superwofy/E9X-M-CAN-Integration-Module/CAN messages/F-series BN2010/0x5E3 iDrive settings to other modules.txt

Independent ventilation Timer2:
11 03 00 02 03 17 FD FF                             // Active: 3:23, Identical to BN2000 0x5E2
