superwofy/E9X-M-CAN-Integration-Module/CAN messages/F-series BN2010/0x291 Sport displays unit settings.txt

Byte4 first half - Torque
Byte4 second half - Power

Torque:

Nm:
00 03 00 00 10 F0

Ft lb:
00 03 00 00 20 F0

kgm:
00 03 00 00 30 F0

Power:

KW:
00 03 00 00 01 F0

hp:
00 03 00 00 02 F0
