superwofy/E9X-M-CAN-Integration-Module/CAN messages/E-series BN2000/0x130 terminal status.png

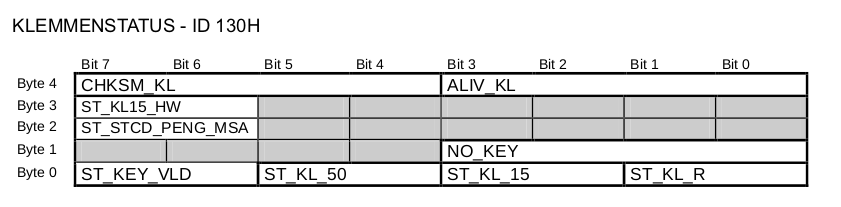
CAN messages/E-series BN2000/0x130 terminal status.png
