superwofy/E9X-M-CAN-Integration-Module/CAN messages/F-series BN2010/0x1A1 Speed.png

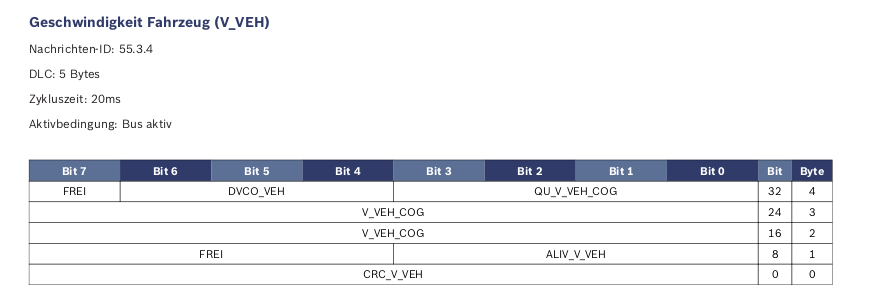
CAN messages/F-series BN2010/0x1A1 Speed.png
