superwofy/E9X-M-CAN-Integration-Module/Firmware changes/SVT70 Servotronic/BDM pinout.jpg

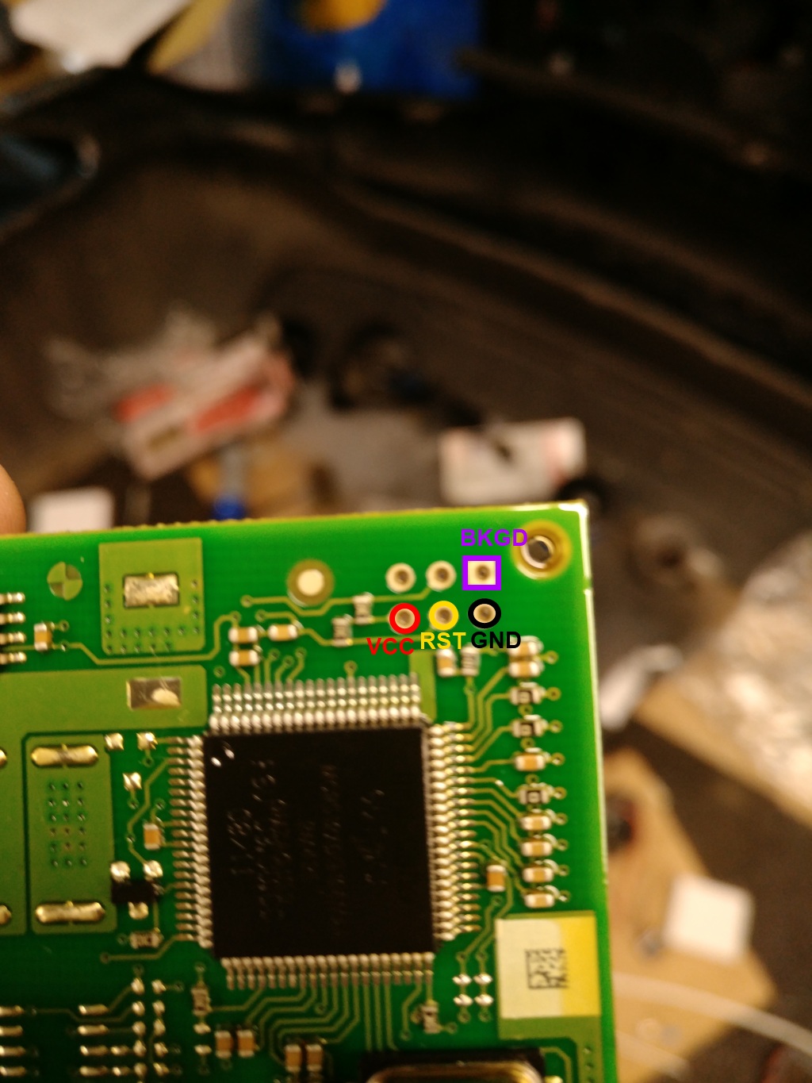
Firmware changes/SVT70 Servotronic/BDM pinout.jpg
