superwofy/E9X-M-CAN-Integration-Module/Images/board/board-back.jpg

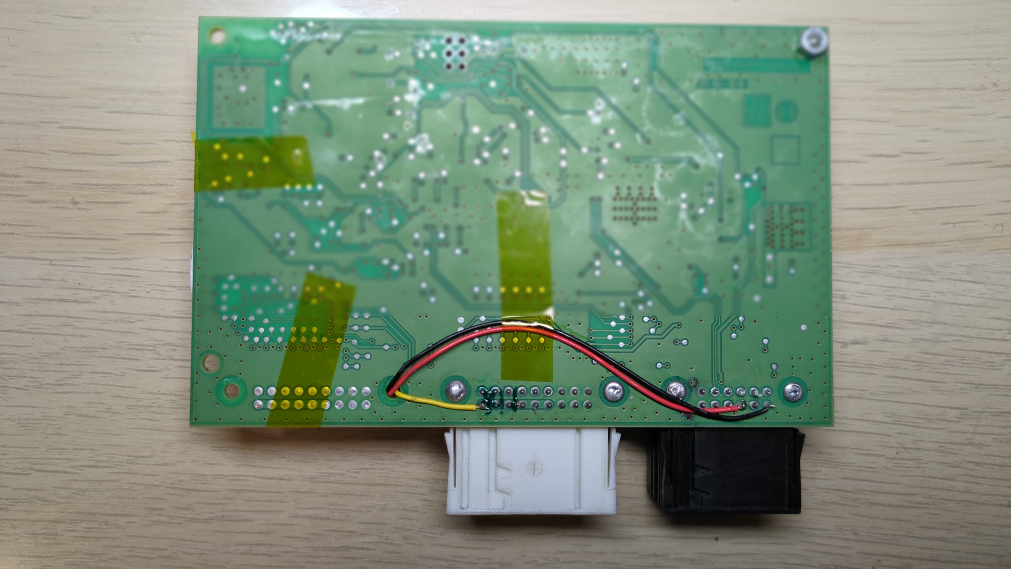
Images/board/board-back.jpg
