superwofy/E9X-M-CAN-Integration-Module/Images/CIC/idrive-settings.jpg

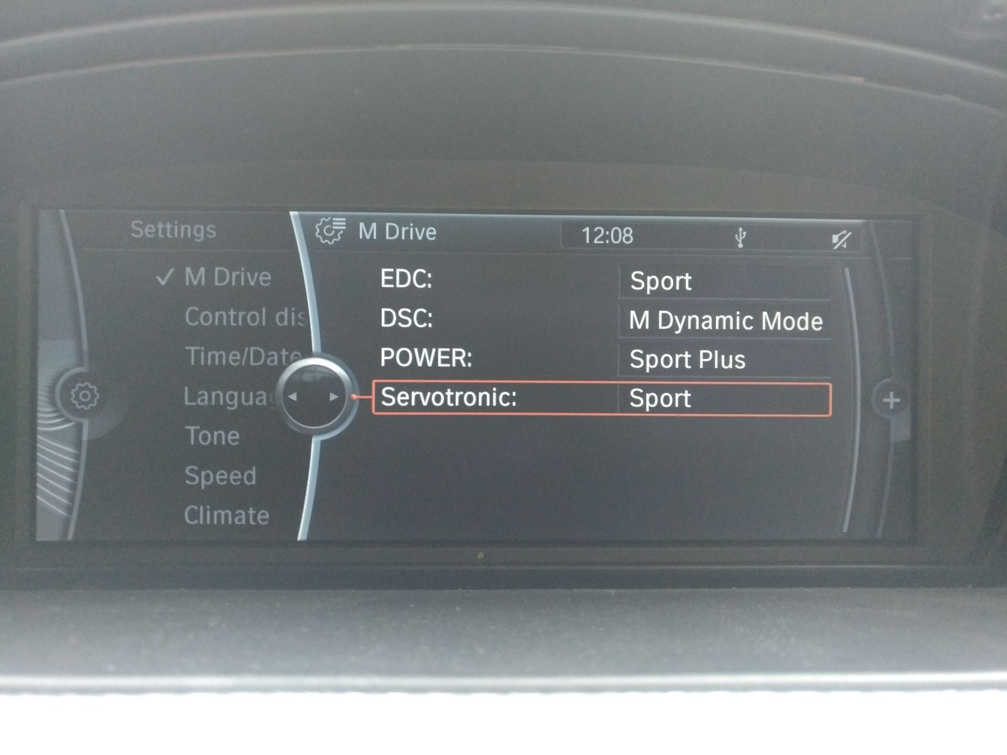
Images/CIC/idrive-settings.jpg
