superwofy/E9X-M-CAN-Integration-Module/Images/CIC/m-key-settings.jpg

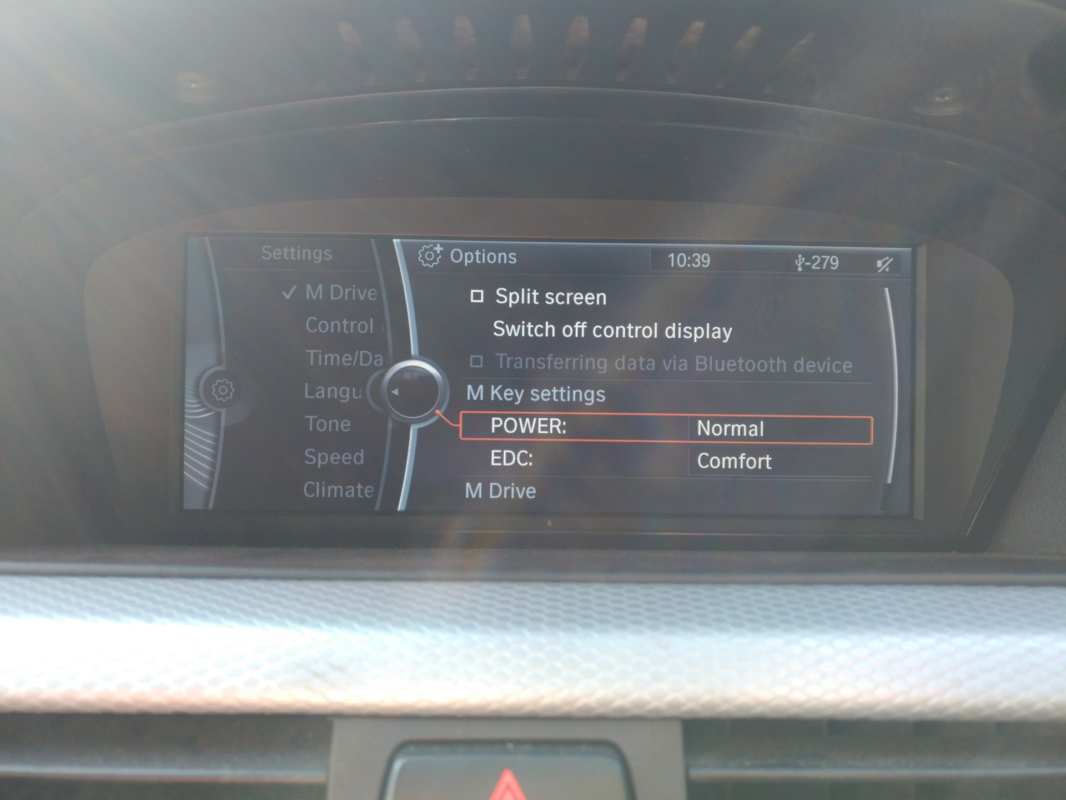
Images/CIC/m-key-settings.jpg
