superwofy/E9X-M-CAN-Integration-Module/Images/cpu-clock-temperature-lifetime.png

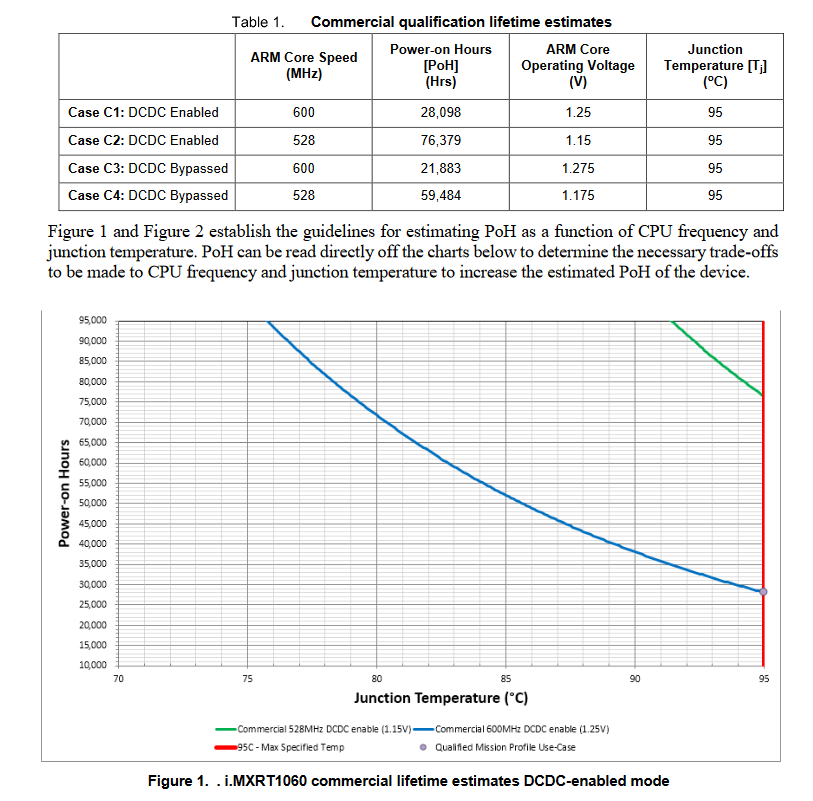
Images/cpu-clock-temperature-lifetime.png
