superwofy/E9X-M-CAN-Integration-Module/Images/exhaust-flap-flyback.jpg

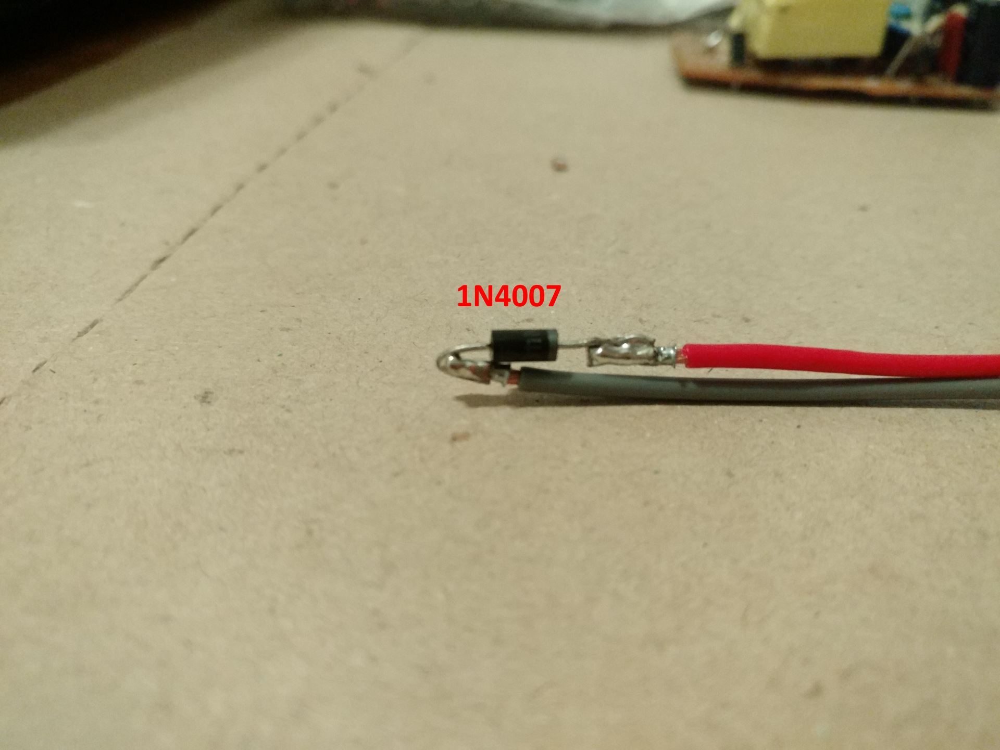
Images/exhaust-flap-flyback.jpg
