superwofy/E9X-M-CAN-Integration-Module/Images/Fog/indicator off.jpg

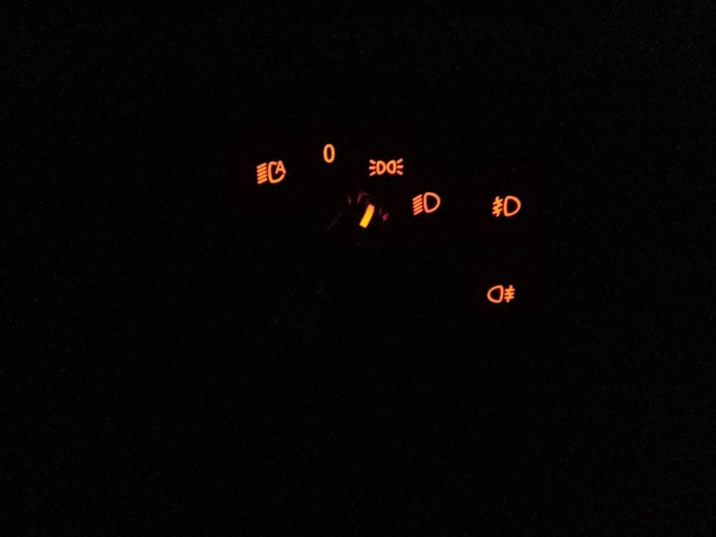
Images/Fog/indicator off.jpg
