superwofy/E9X-M-CAN-Integration-Module/Images/Fog/light switch.jpg

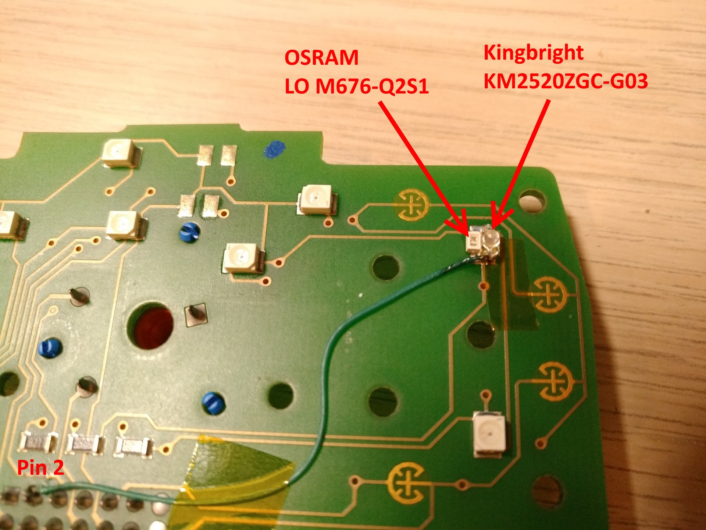
Images/Fog/light switch.jpg
