superwofy/E9X-M-CAN-Integration-Module/Images/launch-control/cid.jpg

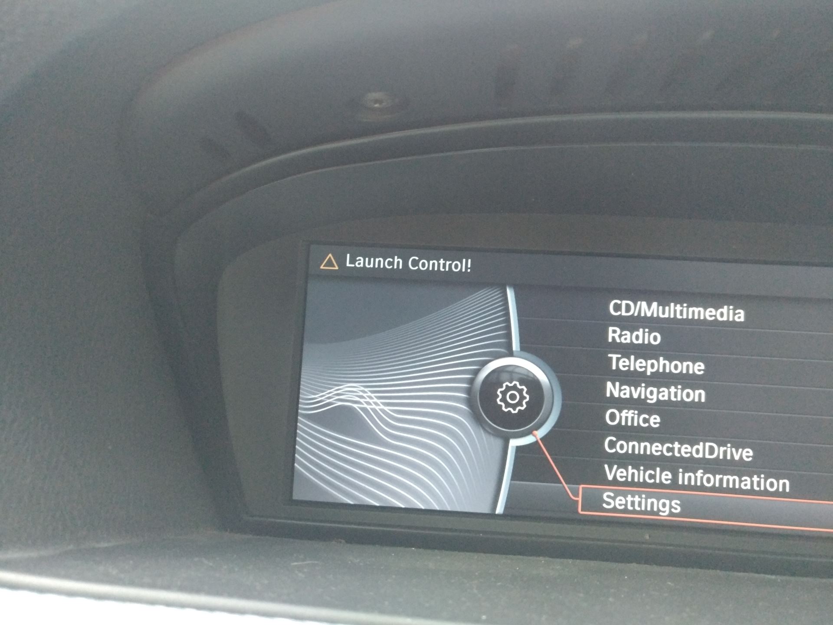
Images/launch-control/cid.jpg
