superwofy/E9X-M-CAN-Integration-Module/Images/NBT/faceplate - pinout.jpg

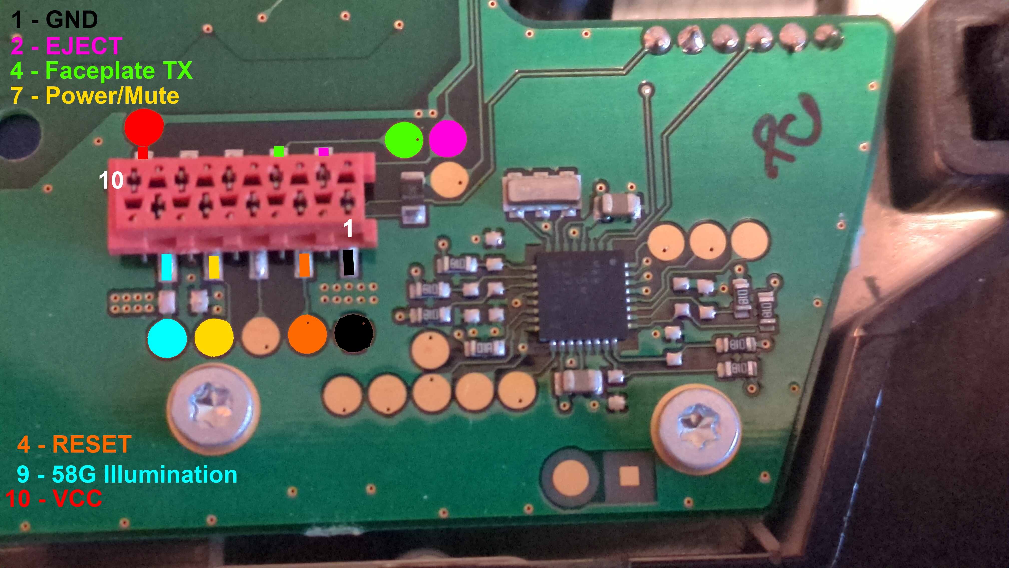
Images/NBT/faceplate - pinout.jpg
