superwofy/E9X-M-CAN-Integration-Module/Images/NBT/fds.jpg

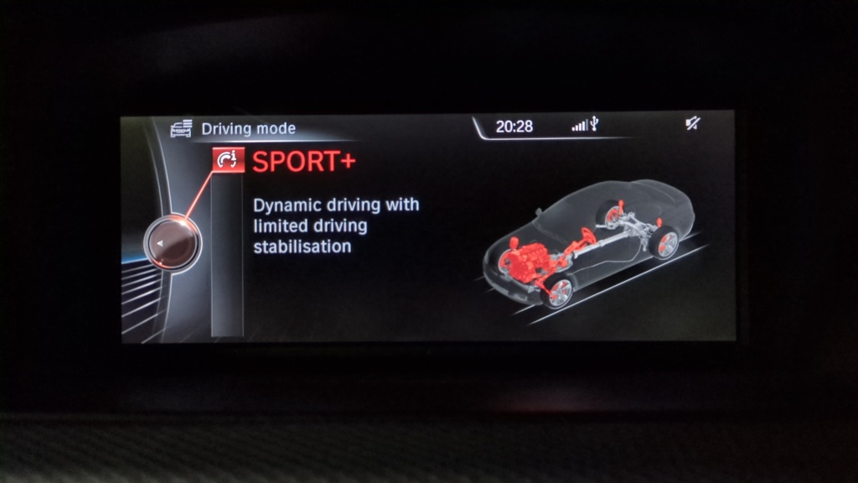
Images/NBT/fds.jpg
