superwofy/E9X-M-CAN-Integration-Module/Images/NBT/mdrive.jpg

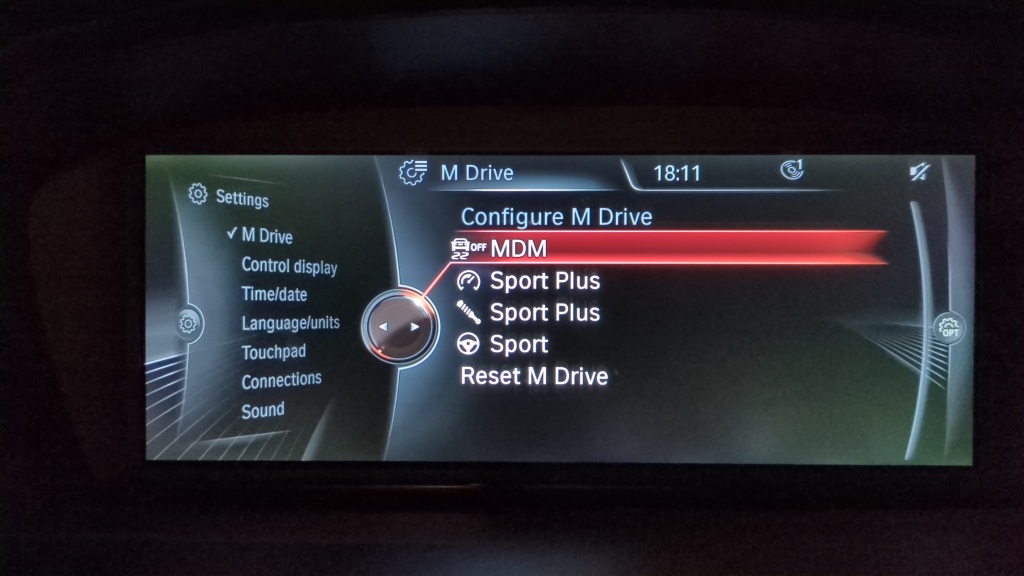
Images/NBT/mdrive.jpg
