superwofy/E9X-M-CAN-Integration-Module/Images/NBT/oil-level.jpg

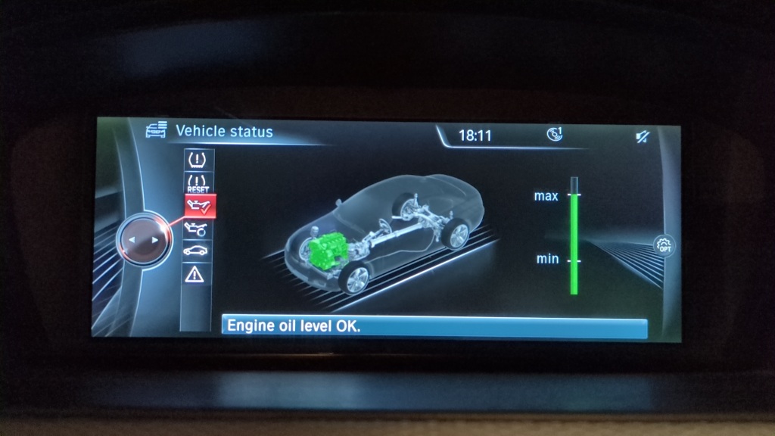
Images/NBT/oil-level.jpg
