superwofy/E9X-M-CAN-Integration-Module/Images/NBT/rpa.jpg

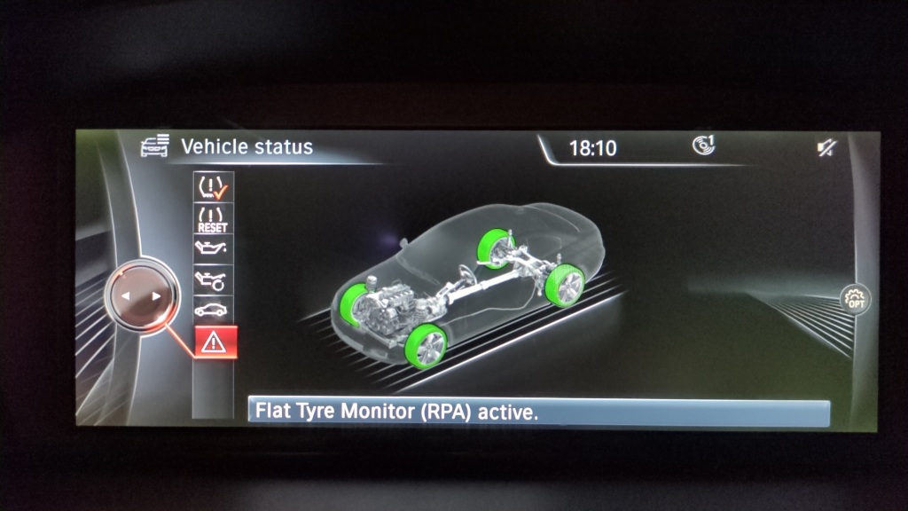
Images/NBT/rpa.jpg
