superwofy/E9X-M-CAN-Integration-Module/Images/NBT/service.jpg

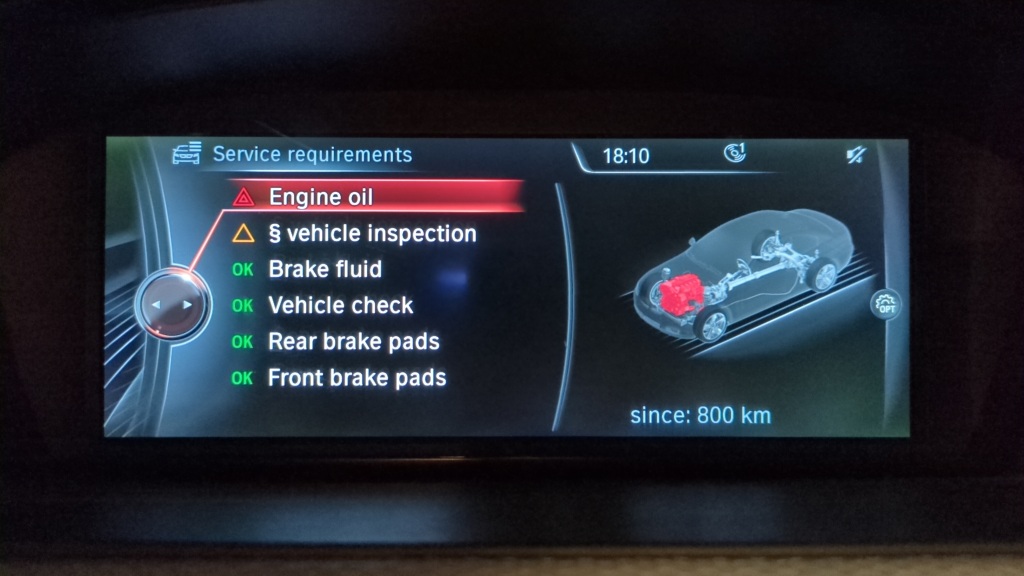
Images/NBT/service.jpg
