superwofy/E9X-M-CAN-Integration-Module/Images/NBT/sport-displays.jpg

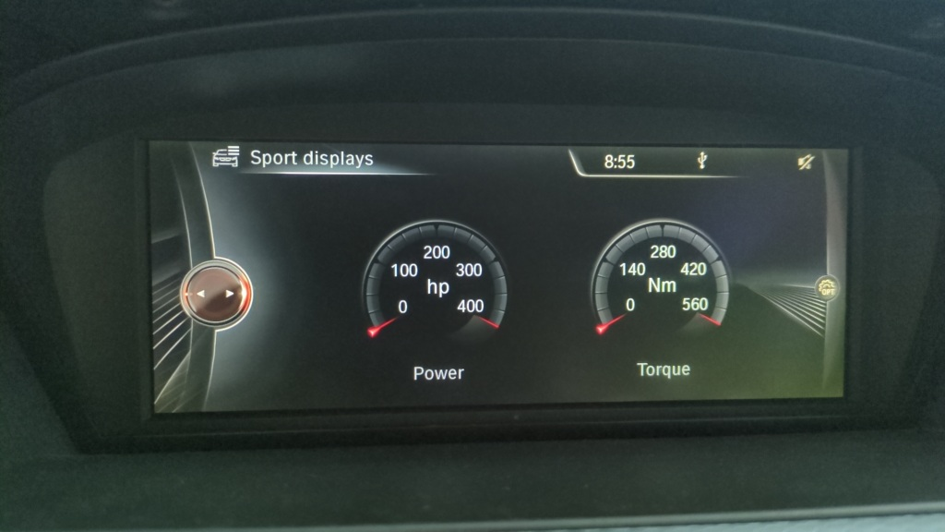
Images/NBT/sport-displays.jpg
