superwofy/E9X-M-CAN-Integration-Module/Images/POWER LED pcb.jpg

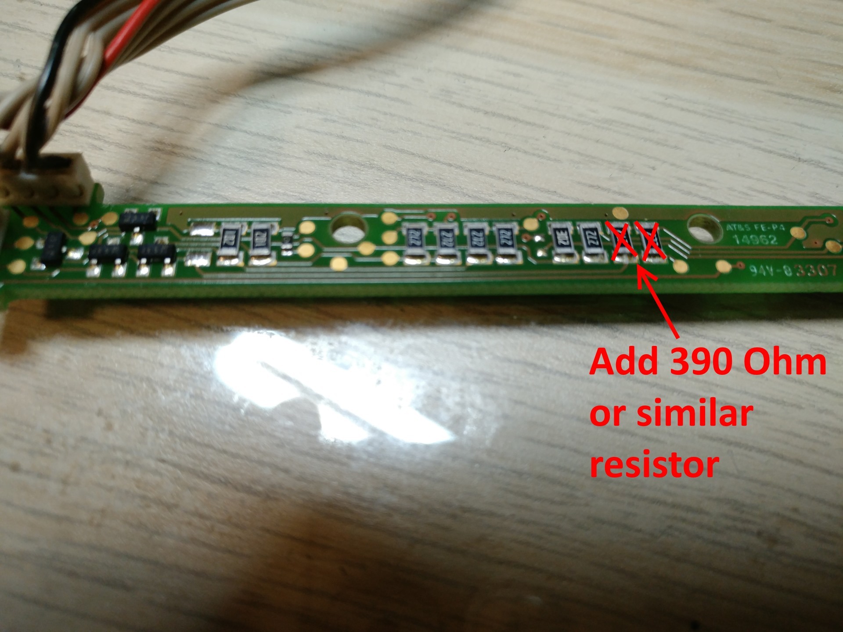
Images/POWER LED pcb.jpg
