superwofy/E9X-M-CAN-Integration-Module/Images/PTC heater/pwm circuit.jpg

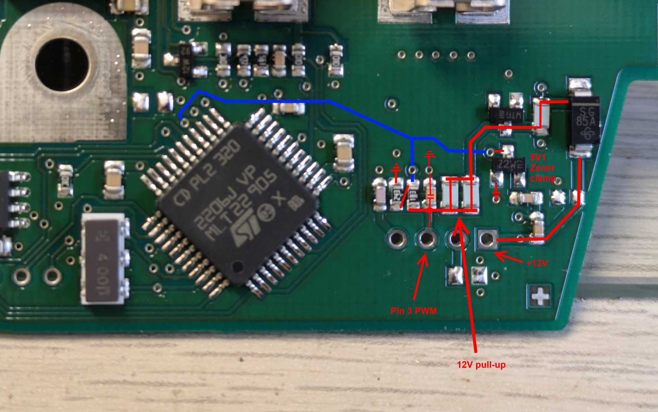
Images/PTC heater/pwm circuit.jpg
