superwofy/E9X-M-CAN-Integration-Module/img/board-all.jpg

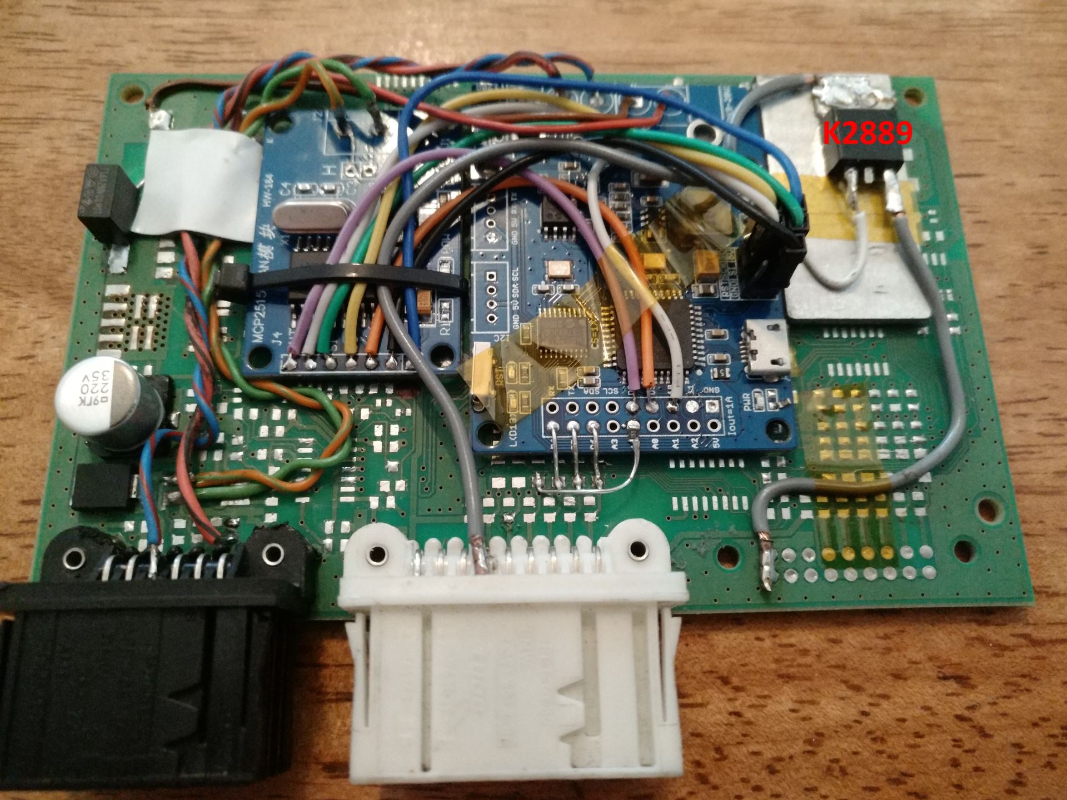
img/board-all.jpg
