superwofy/E9X-M-CAN-Integration-Module/Variable redline/kombi redline.jpg

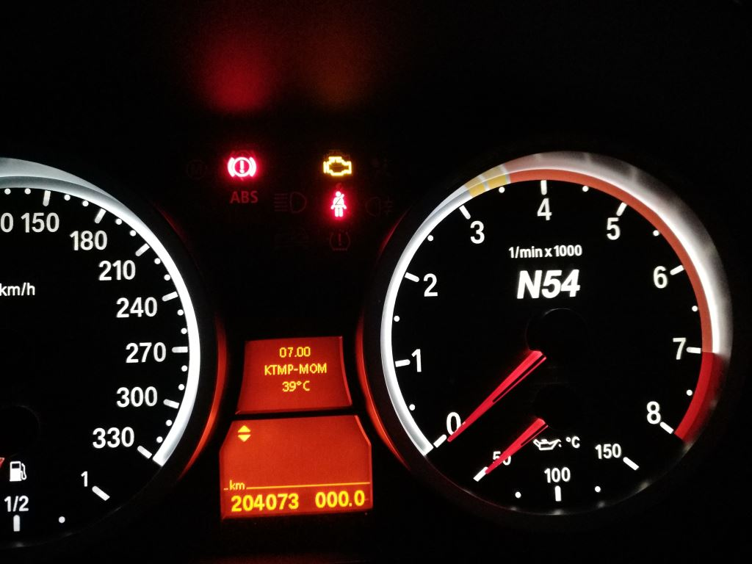
Variable redline/kombi redline.jpg
