superwofy/E9X-M-CAN-Integration-Module/Variable redline/redline graph.png

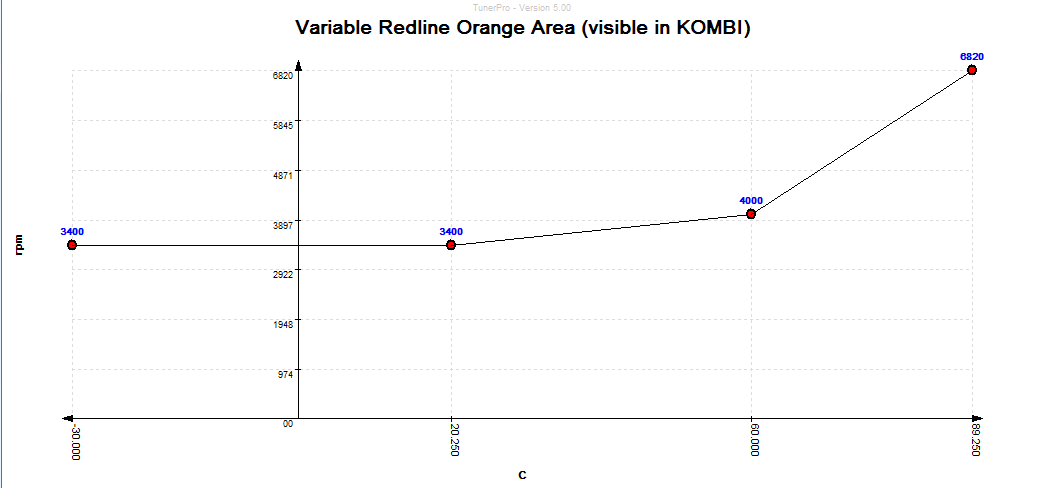
Variable redline/redline graph.png
