superwofy/E9X-M-CAN-Integration-Module/Variable redline/redline settings.png

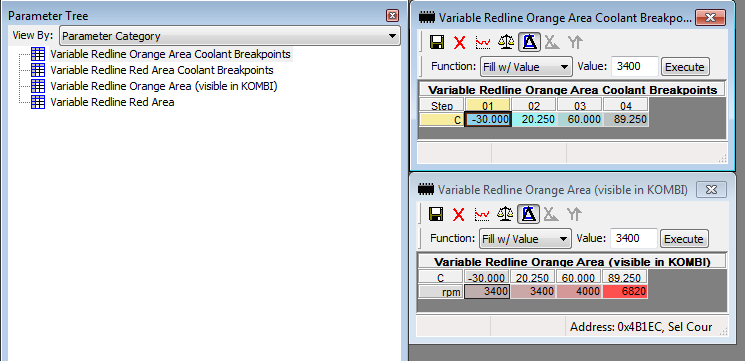
Variable redline/redline settings.png
