superwofy/E9X-M-CAN-Integration-Module/Images/NBT/ribbon soldered.jpg

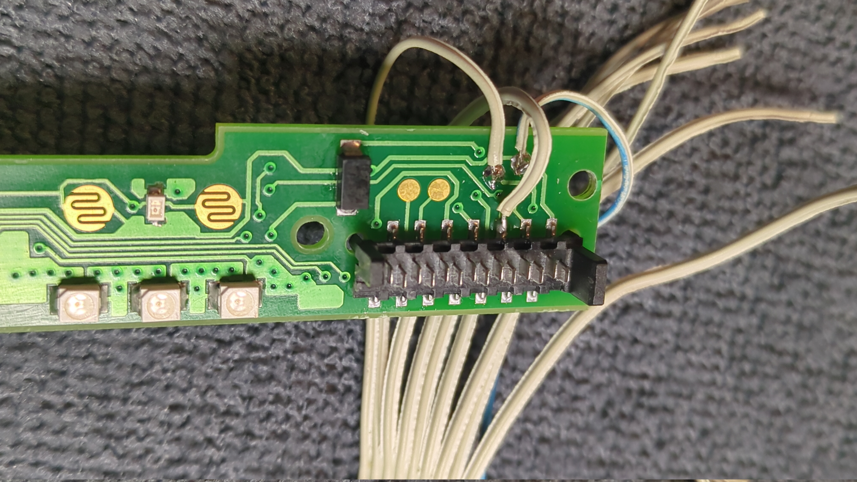
Images/NBT/ribbon soldered.jpg
