superwofy/E9X-M-CAN-Integration-Module/Firmware changes/DME MSD81/msd80 sport mode check.png

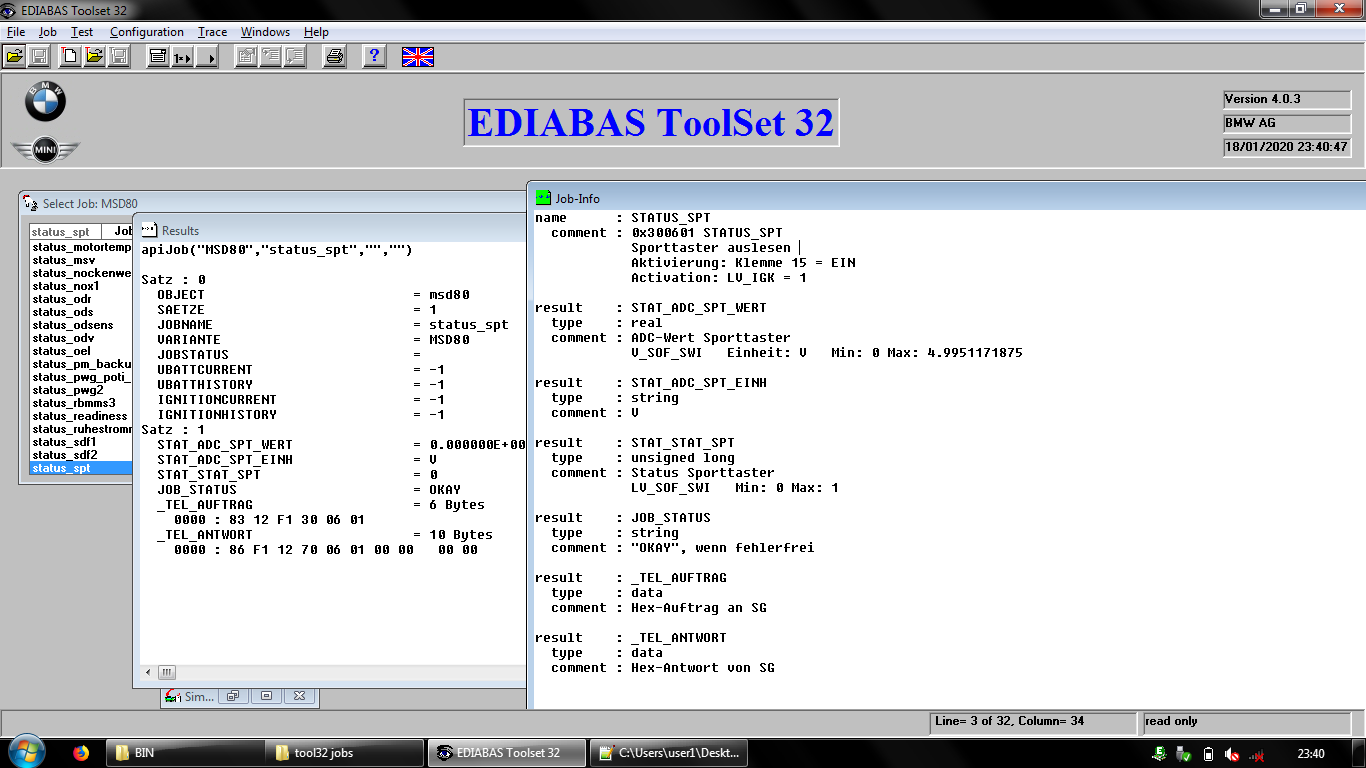
Firmware changes/DME MSD81/msd80 sport mode check.png
