superwofy/E9X-M-CAN-Integration-Module/Firmware changes/DME MSD81/Original CAN filters IKM0S.png

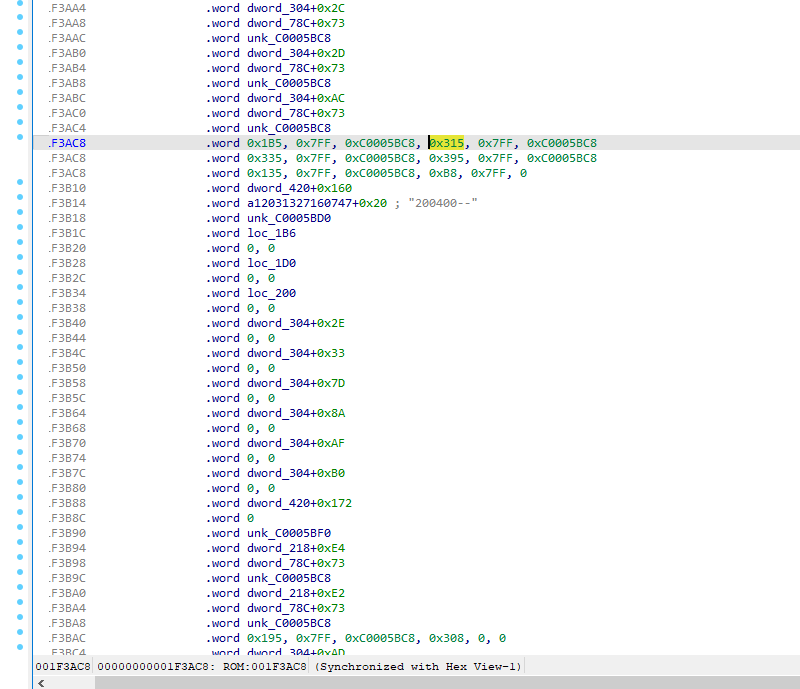
Firmware changes/DME MSD81/Original CAN filters IKM0S.png
