superwofy/E9X-M-CAN-Integration-Module/Firmware changes/DME MSD81/Original CAN table IKM0S.png

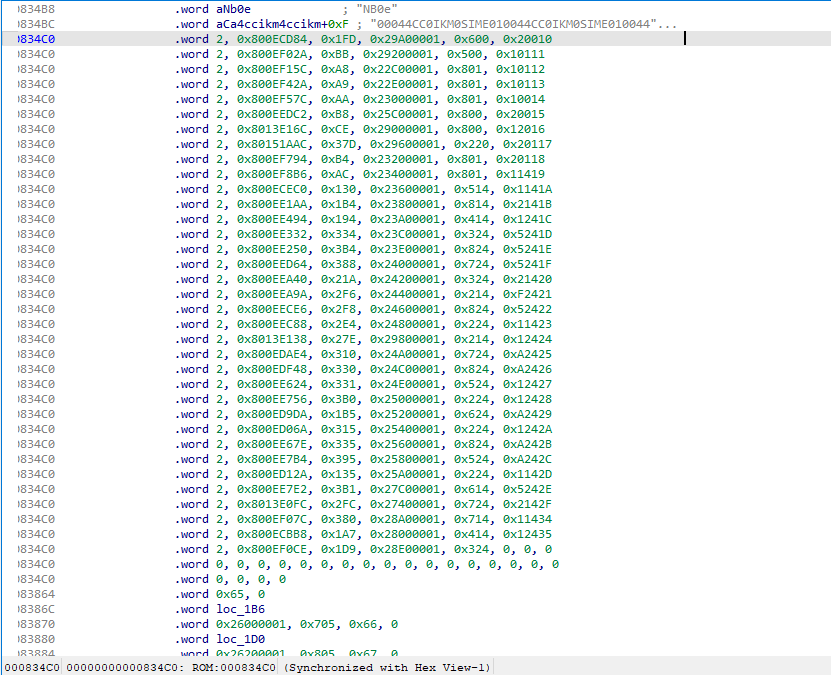
Firmware changes/DME MSD81/Original CAN table IKM0S.png
