superwofy/E9X-M-CAN-Integration-Module/(threads)

Thread 1 (2023-07-14):

Not an issue. Just something I found in the web regarding exhaust valve controlling.

Xantorhd, 2023-07-14:
Hey superwofy,

as stated in the title I found something special. I don't know whether you are interested but it's worth sharing imo.

It seems like the Exhaust valve is controlled via (I guess) PT-CAN. Message ID would be "0x6F1". Found it here:

https://f80.bimmerpost.com/forums/showthread.php?t=1366350

It's a good read. It only forces it open though. Must be a way to force it shut as well. I know it's for an F series M car but maybe BMW built that upon the existing logic on E series cars.

Hope this helps as it would be an oem+ route rather than depinning and installing a diode to control.

Cheers!

superwofy, 2023-07-14:
Apologies, I forgot to reply to this.

I did see and consider this prior but did not implement it because of a note in the IKM0S DME function manual.
It would indeed make the hardware simpler, I'd love to get rid of the transistor.

```
The flag LV_AD_DIS_EXT_ADJ is set when an external adustment is done. The flag is set back to zero
at ECU reset.
```

What I believe this implies is that for the particular drive cycle where you call this, the DME will no longer create adaptations. That's not a concession I'm willing to make.

Closed 2023-07-14.

Thread 4 (2024-06-11):

Yawrate/ NBT Entrynav

pchq4205, 2024-06-11:
Hello,
i saw you Projekt and ported some of it to one of my "Special-Retrofits" in my Car.
But i still dont understand one thing. How the Gyro emulation works.
Do you have an easier understandable example how to implement random Values to get GPS to working.
Because since the NBT Entrynav dont have an Build in Gyro i have to emulate something.
(And i am using an Arduino Mega with the standart Can Bus shield)
Thank you :)
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

superwofy, 2024-06-15:
Hello,

The yaw rate is processed by the radio on CANID 0x2F3 or 0x19F. This is dependant on the gateway table coding. 0x2F3 for PL4-like cars, 0x19F for PL6. PL4: F20, F30, etc. PL6: F10, F11, etc.

If you look at function send_f_yaw_rate_chassis(), you will understand how it's encoded such that BMW radios understand it.

Your challenge will be to somehow obtain a lateral acceleration value from your VW and feed it to that function. Essentially substitute e_yaw_rate with your own degrees/s value. You could use an accelerometer if that is not available in your car.

Closed 2024-06-21.

Thread 6 (2025-02-26):

Steering angle question

TechOverflow, 2025-02-26:
Hi @superwofy,
Great wealth of information in this repo!
If I understand correctly, you're taking E9x non-M CAN messages and forwarding them to an M cluster, but you're also doing some routing between different buses.
I've got a non-M cluster (I believe facelift) setup on the bench and am trying to satisfy two error warnings - steering and SOS. In the case of steering, I'd be happy with just a fixed angle forever, just to fool the cluster and get rid of the warnings, but I don't have the actual car to sniff traffic.
I see you've [logged](https://github.com/superwofy/E9X-M-CAN-Integration-Module/blob/main/CAN%20messages/E-series%20BN2000/0xC8%20Steering%20angle.txt) 0x0C8, but on PT-CAN. Would you happen to have any logs or info about the steering angle on K-CAN?
The [loopybunny](https://www.loopybunny.co.uk/CarPC/k_can.html) site suggests 0x0C4 and 0x0C8, but without timing and info on whether any of the bits are a timer or CRC, also from an E84, which might be slightly different.
Cheers!

TechOverflow, 2025-03-12:
Thanks for the trace! That helped find clues for the SOS warning.
The "Active steering deactivated!" warning is still nagging me though.
Would you happen to know if the logged car has AFS? If not, I'll need to search for logs from a car known to have AFS.

superwofy, 2025-03-13:
> Thanks for the trace! That helped find clues for the SOS warning. The "Active steering deactivated!" warning is still nagging me though. Would you happen to know if the logged car has AFS? If not, I'll need to search for logs from a car known to have AFS.

Sadly, no. M3s did not have AFS. In fact I've yet to see a BMW with AFS here.

Closed 2025-03-13.
