superwofy/E9X-M-CAN-Integration-Module/coding parameters.txt

# NBT EVO ID5/6 23-07, Coded as F082 3R91 or 3R92.

SERVICE_HISTORY                                                         // Disable service history in Vehicle status
    nicht_aktiv
IBA                                                                     // Disables owner's manual
    nicht_aktiv
SETTINGS_TIME_AUTOMATIC                                                 // Update time with GPS
    navigation
MMI_STATISTIK                                                           // Disable some logging
    nicht_aktiv
HELLIGKEIT_AMBILIGHT                                                    // Disable interior brightness setting
    nicht_aktiv
DEAKTIVIERUNGSMOEGLICHKEIT_AMBILIGHT
    deaktivierung_bmw
COLOUR_SWITCH
    nicht_aktiv
MACRO_CAM_LEGALDISCLAIMER                                               // Camera disclaimer
    kein_ld
COMMUNICATION_PARKMASTER                                                // PDC not working without this.
    gen2
SLEEPDELAY_CLAMP30B_MIN                                                 // Sleep after 5 min
    1E
ECO_CSC_KOMBI
    nicht_aktiv
ID5_COLOR_SET
    nicht_aktiv
CC_CBS_ETH_SERVICE_VERSION
    version_1
M_DIGITAL_TACHO
    nicht_aktiv
SETTINGS_INFO_DISPLAY
    nicht_aktiv
SETTINGS_INFO_DISPLAY_DATE
    nicht_aktiv
KEY_CONF_TAILGATE                                                       // Hides tailgate button menu
    nicht_aktiv
M_MENUE                                                                 // M Setup instead of MDrive
    aktiv
MDRIVE_CONFIG                                                           // Single MDrive
    1_menu
ECO_MODE                                                                // Deactivates ECO mode and Efficient dynamics
    nicht_aktiv
HIST_ZOOM
    nicht_aktiv
HIST_GAS_CONSUMP
    nicht_aktiv
DRIVE_EXP_BRW
    nicht_aktiv
MACRO_FDS                                                               // FDS popup display
    only_popup
CAM_ECU                                                                 // VSW output connected to +21, -24 and shield 23 of A42*1B.
    wert_1
TV
    wert_1
BASIS_KOMBI_MMI_LIST
    aktiv
GATEWAYTABLE
    table_7
PRODUKTLINIE
    lg
KOMBI_CIC
    kombi_low
CAMERA_SYSTEM
    trsvc
X_VIEW                                                                  // xDrive status
    aktiv
COMPASS
    aktiv
OELSTAND_OENS                                                           // Old CIC-like Oil menu
    nicht_aktiv
LANGUAGE_CZECH                                                          // Unsupported languages
    nicht_aktiv
LANGUAGE_DANISH
    nicht_aktiv
LANGUAGE_NORWEGIAN
    nicht_aktiv
LANGUAGE_SLOVENIAN
    nicht_aktiv
LANGUAGE_SLOVAKIAN
    nicht_aktiv
LANGUAGE_FINNISH
    nicht_aktiv


# CIC

CIC_MDRIVE                                                              // Enables M3 MDrive
    aktiv
M_KEY_SETTINGS                                                          // Enables M3 key profile settings
    aktiv
EDC_CIC                                                                 // EDC, if retrofitted.
    aktiv
DSC_OFF_CIC                                                             // Allows disabling DSC from MDrive menu,
    aktiv
MACRO_L6_PARKMENU                                                       // Rear view camera settings
    aktiv



# KOMBI

MMI_ENA_SHIFTLIGHTS                                                     // Enable shiftlights
    aktiv
DSC_VARIANTE                                                            // Changes DSC symbol when disabled, disables DTC mode kombi screen warning
    wert_02
CC_ID_AKTIV_11
    // Change the second byte from 0xFF to 0x7D (i.e 11111111 to 01111101)
    // This disables the Ignition On door open CC.
    // This is required to make the DOOR_VOLUME feature work.



# IHKA

MSA                                                                     // Activates the Auto-Start-Stop button.
    aktiv



# SVT 70: E70 X5M params

KENNLINIEN1_3_NORM
    wert_07
KENNLINIEN1_3_SPORT
    wert_02
    wert_03
    wert_04
KENNLINIEN4_6_NORM
    wert_07
KENNLINIEN4_6_SPORT
    wert_02
    wert_03
    wert_04
REGLERPARAMETER
    wert_01
STUETZSTELLEN_V_LW
    wert_01
WANDLERKENNLINIE
    wert_01
BETRIEBSWERTE
    wert_01



# JBBF3R

PIA_EDC                                                                 // Enables EDC M3 key profile setting.
    mit_mmi
EDC_LED_SWITCH                                                          // Enables EDC button instead of Servotronic PWM from JBE.
    aktiv
DSC_SWITCH                                                              // Disabled for M3 hazards cluster.
    nicht_aktiv
RPA_SWITCH                                                              // Enables the Flat tyre monitor reset button.
    aktiv



# FRM

ASP_KOMFORT_EINKLAPP                                                    // Disable the original comfort fold mirror behavior.
    nicht_aktiv
MAX_SCHWENK_V_H_BEGR_SP                                                 // Faster swivel speed (horizontal) in sport mode.
    wert_21
