superwofy/E9X-M-CAN-Integration-Module/E9X-M-CAN-Integration-Module/program-functions.ino

// Functions related to the operation of the program and debugging go here.


void read_initialize_eeprom(void) {
  uint16_t stored_eeprom_checksum = EEPROM.read(0) << 8 | EEPROM.read(1);
  uint16_t calculated_eeprom_checksum = calculate_eeprom_crc();

  if (stored_eeprom_checksum != calculated_eeprom_checksum){
    sprintf(serial_debug_string, "EEPROM data corrupted. Stored checksum: 0x%X, calculated checksum: 0x%X. Restoring defaults.",
            stored_eeprom_checksum, calculated_eeprom_checksum);
    serial_log(serial_debug_string, 1);

    EEPROM.update(2, mdrive_dsc[0]);                                                                                                // MDrive
    EEPROM.update(3, mdrive_power[0]);
    EEPROM.update(4, mdrive_edc[0]);
    EEPROM.update(5, mdrive_svt[0]);
    EEPROM.update(6, 0xFF);                                                                                                         // Blank for future use
    EEPROM.update(7, 0xFF);
    EEPROM.update(8, mdrive_dsc[1]);
    EEPROM.update(9, mdrive_power[1]);
    EEPROM.update(10, mdrive_edc[1]);
    EEPROM.update(11, mdrive_svt[1]);   
    EEPROM.update(12, 0xFF);
    EEPROM.update(13, 0xFF);
    EEPROM.update(14, mdrive_dsc[2]);
    EEPROM.update(15, mdrive_power[2]);
    EEPROM.update(16, mdrive_edc[2]);
    EEPROM.update(17, mdrive_svt[2]);
    EEPROM.update(18, 0xFF);
    EEPROM.update(19, 0xFF);
    EEPROM.update(20, 0xF1);                                                                                                        // DME CKM
    EEPROM.update(21, 0xF1);
    EEPROM.update(22, 0xF1);
    EEPROM.update(23, 1);                                                                                                           // Torque / Power units
    EEPROM.update(24, 1);
    EEPROM.update(25, 1);
    EEPROM.update(26, 1);
    EEPROM.update(27, 1);
    EEPROM.update(28, 1);
    EEPROM.update(29, 0);                                                                                                           // Un-fold exterior mirrors when unlocking
    EEPROM.update(30, 1);                                                                                                           // Immobilizer
    EEPROM.update(31, 1);
    EEPROM.update(33, 0x10);                                                                                                        // CIC persistent volume
    EEPROM.update(34, 0);                                                                                                           // Visual acknowledge CKM
    EEPROM.update(35, 0);
    EEPROM.update(36, 0);
    EEPROM.update(37, 0);                                                                                                           // Automatic seat position CKM
    EEPROM.update(38, 0);
    EEPROM.update(39, 0);
    EEPROM.update(40, 1);                                                                                                           // DRL CKM
    EEPROM.update(41, 1);
    EEPROM.update(42, 1);
    EEPROM.update(43, 0);
    EEPROM.update(44, 0);                                                                                                           // Door locks
    EEPROM.update(45, 0);
    EEPROM.update(46, 9);                                                                                                           // Pressure units and date format.
    EEPROM.update(47, 9);
    EEPROM.update(48, 9);
    EEPROM.update(49, 4);                                                                                                           // Loglevel
    EEPROM.update(50, 5);                                                                                                           // IHKA auto states
    EEPROM.update(51, 3);
    EEPROM.update(52, 0);
    EEPROM.update(53, 0);

    update_eeprom_checksum();
  } else {
    mdrive_dsc[0] = EEPROM.read(2);
    mdrive_power[0] = EEPROM.read(3);
    mdrive_edc[0] = EEPROM.read(4);
    mdrive_svt[0] = EEPROM.read(5);
    mdrive_dsc[1] = EEPROM.read(8);
    mdrive_power[1] = EEPROM.read(9);
    mdrive_edc[1] = EEPROM.read(10);
    mdrive_svt[1] = EEPROM.read(11);
    mdrive_dsc[2] = EEPROM.read(14);
    mdrive_power[2] = EEPROM.read(15);
    mdrive_edc[2] = EEPROM.read(16);
    mdrive_svt[2] = EEPROM.read(17);
    #if !F_NBTE                                                                                                                      // NBT does not have M-Key settings.
      dme_ckm[0][0] = EEPROM.read(20);
      dme_ckm[1][0] = EEPROM.read(21);
      dme_ckm[2][0] = EEPROM.read(22);
    #else
      torque_unit[0] = EEPROM.read(23);
      power_unit[0] = EEPROM.read(24);
      torque_unit[1] = EEPROM.read(25);
      power_unit[1] = EEPROM.read(26);
      torque_unit[2] = EEPROM.read(27);
      power_unit[2] = EEPROM.read(28);
      pressure_unit_date_format[0] = EEPROM.read(46);
      pressure_unit_date_format[1] = EEPROM.read(47);
      pressure_unit_date_format[2] = EEPROM.read(48);
    #endif
    unfold_with_door_open = EEPROM.read(29) == 1 ? true : false;
    immobilizer_released = EEPROM.read(30) == 1 ? true : false;
    immobilizer_persist = EEPROM.read(31) == 1 ? true : false;
    if (!immobilizer_persist) {
      immobilizer_released = true;                                                                                                  // Deactivate immobilizer at boot if this value is set.
    }
    #if DOOR_VOLUME && !F_NBTE
      peristent_volume = EEPROM.read(33);
      if (peristent_volume > 0x33) {
        peristent_volume = 0x15;
      } else if (peristent_volume == 0) {
        peristent_volume = 0x10;
      }
    #endif
    visual_signal_ckm[0] = EEPROM.read(34) == 1 ? true : false;
    visual_signal_ckm[1] = EEPROM.read(35) == 1 ? true : false;
    visual_signal_ckm[2] = EEPROM.read(36) == 1 ? true : false;
    auto_seat_ckm[0] = EEPROM.read(37) == 1 ? true : false;
    auto_seat_ckm[1] = EEPROM.read(38) == 1 ? true : false;
    auto_seat_ckm[2] = EEPROM.read(39) == 1 ? true : false;
    drl_ckm[0] = EEPROM.read(40) == 1 ? true : false;
    drl_ckm[1] = EEPROM.read(41) == 1 ? true : false;
    drl_ckm[2] = EEPROM.read(42) == 1 ? true : false;
    serial_commands_unlocked = EEPROM.read(43) == 1 ? true : false;
    doors_locked = EEPROM.read(44) == 1 ? true : false;
    doors_alarmed = EEPROM.read(45) == 1 ? true : false;
    LOGLEVEL = constrain(EEPROM.read(49), 0, 4);
    ihka_auto_fan_speed = EEPROM.read(50);
    ihka_auto_fan_state = EEPROM.read(51);
    ihka_recirc_state = EEPROM.read(52);
    ihka_auto_distr_state = EEPROM.read(53);
    serial_log("Loaded data from EEPROM.", 2);
  }
}


uint16_t calculate_eeprom_crc(void) {
  teensy_eeprom_crc.restart();
  for (uint8_t i = 2; i < 54; i++) {
    teensy_eeprom_crc.add(EEPROM.read(i));
  }
  return teensy_eeprom_crc.calc();
}


void update_data_in_eeprom(void) {                                                                                                  // EEPROM lifetime approx. 100k writes. Always update, never write()!
  if (!key_guest_profile) {
    EEPROM.update(2, mdrive_dsc[0]);
    EEPROM.update(3, mdrive_power[0]);
    EEPROM.update(4, mdrive_edc[0]);
    EEPROM.update(5, mdrive_svt[0]);
    EEPROM.update(8, mdrive_dsc[1]);
    EEPROM.update(9, mdrive_power[1]);
    EEPROM.update(10, mdrive_edc[1]);
    EEPROM.update(11, mdrive_svt[1]);
    EEPROM.update(14, mdrive_dsc[2]);
    EEPROM.update(15, mdrive_power[2]);
    EEPROM.update(16, mdrive_edc[2]);
    EEPROM.update(17, mdrive_svt[2]);
  }
  #if !F_NBTE
    EEPROM.update(20, dme_ckm[0][0]);
    EEPROM.update(21, dme_ckm[1][0]);
    EEPROM.update(22, dme_ckm[2][0]);
  #else
    EEPROM.update(23, torque_unit[0]);
    EEPROM.update(24, power_unit[0]);
    EEPROM.update(25, torque_unit[1]);
    EEPROM.update(26, power_unit[1]);
    EEPROM.update(27, torque_unit[2]);
    EEPROM.update(28, power_unit[2]);
    EEPROM.update(46, pressure_unit_date_format[0]);
    EEPROM.update(47, pressure_unit_date_format[1]);
    EEPROM.update(48, pressure_unit_date_format[2]);
  #endif
  EEPROM.update(29, unfold_with_door_open);
  #if DOOR_VOLUME && !F_NBTE
    EEPROM.update(33, peristent_volume);
  #endif
  EEPROM.update(34, visual_signal_ckm[0]);
  EEPROM.update(35, visual_signal_ckm[1]);
  EEPROM.update(36, visual_signal_ckm[2]);
  EEPROM.update(37, auto_seat_ckm[0]);
  EEPROM.update(38, auto_seat_ckm[1]);
  EEPROM.update(39, auto_seat_ckm[2]);
  EEPROM.update(40, drl_ckm[0]);
  EEPROM.update(41, drl_ckm[1]);
  EEPROM.update(42, drl_ckm[2]);
  EEPROM.update(44, doors_locked);
  EEPROM.update(45, doors_alarmed);
  EEPROM.update(49, LOGLEVEL);
  EEPROM.update(50, ihka_auto_fan_speed);
  EEPROM.update(51, ihka_auto_fan_state);
  EEPROM.update(52, ihka_recirc_state);
  EEPROM.update(53, ihka_auto_distr_state);
  update_eeprom_checksum();
}


void update_eeprom_checksum(void) {
  uint16_t new_eeprom_checksum = calculate_eeprom_crc();
  EEPROM.update(0, new_eeprom_checksum >> 8);
  EEPROM.update(1, new_eeprom_checksum & 0xFF);
}


void initialize_watchdog(void) {
  WDT_timings_t config;
  config.trigger = 20;
  config.callback = wdt_callback;
  config.timeout = 23;                                                                                                              // If the watchdog timer is not reset, re-start the program.
  wdt.begin(config);
  serial_log("WDT initialized.", 2);
}


void wdt_callback(void) {
  serial_log("Watchdog not fed. Program will reset in 3s!", 0);
  update_data_in_eeprom();
}
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
