superwofy/E9X-M-CAN-Integration-Module/E9X-M-CAN-Integration-Module/serial.ino

// Functions that allow the user to send commands to the program go here.


void serial_debug_interpreter(void) {
  String cmd = Serial.readStringUntil('\n', 64);                                                                                    // Limit command the size to prevent overflow. NULL terminator not included.
  if (serial_commands_unlocked) {                                                                                                   // In the unlikely event someone picks up the USB cable and starts sending things.
    if (cmd == "lock_serial") {
      serial_commands_unlocked = false;
      EEPROM.update(43, serial_commands_unlocked);
      update_eeprom_checksum();
      serial_log("  Serial: Commands locked.", 0);
    }
    else if (cmd == "bypass_diag") {
      diag_deactivate_timer = OBD_DETECT_TIMEOUT;
      diag_timeout_active = false;
      diag_transmit = true;
      serial_log("  Serial: OBD tool detection timeout disabled for the current session! Sleep/Reboot to reset.", 0);
    }
    else if (cmd == "loglevel_0") {
      LOGLEVEL = 0;
      serial_log("  Serial: LOGLEVEL set to 0.", 0);
    }
    else if (cmd == "loglevel_1") {
      LOGLEVEL = 1;
      serial_log("  Serial: LOGLEVEL set to 1.", 0);
    }
    else if (cmd == "loglevel_2") {
      LOGLEVEL = 2;
      serial_log("  Serial: LOGLEVEL set to 2.", 0);
    }
    else if (cmd == "loglevel_3") {
      LOGLEVEL = 3;
      serial_log("  Serial: LOGLEVEL set to 3.", 0);
    }
    else if (cmd == "loglevel_4") {
      LOGLEVEL = 4;
      serial_log("  Serial: LOGLEVEL set to 4.", 0);
    }
    else if (cmd == "module_reboot") {
      serial_log("  Serial: Rebooting.", 0);
      if (LOGLEVEL >= 2) {
        Serial.print("  Serial: ");
      } else {
        serial_log("  Serial: Saved data to EEPROM.", 0);
      }
      update_data_in_eeprom();
      delay(1000);
      wdt.reset();
    }
    else if (cmd == "test_watchdog") {
      serial_log("  Serial: Will reboot after watchdog timeout.", 0);
      update_data_in_eeprom();
      delay(1000);
      while(1);
    }
    else if (cmd == "power_down") {
      if (vehicle_awake) {
        if (!terminal_r) {
          if (diag_transmit) {
            serial_log("  Serial: Sending power down command.", 0);
            power_down_requested = true;
            kcan_write_msg(power_down_cmd_a_buf);
          } else {
            obd_timeout_warning();
          }
        } else {
          serial_log("  Serial: Terminal R must be OFF.", 0);
        }
      } else {
        serial_log("  Serial: Wake vehicle first.", 0);
      }
    }
    else if (cmd == "print_status") {
      print_current_state(Serial);
    }
    else if (cmd == "print_boot_log") {
      serial_log("======================== Boot Log ========================", 0);
      Serial.print(boot_debug_string);
      serial_log("==========================================================", 0);
    }
    else if (cmd == "print_can_config") {
      serial_log("========================== KCAN ==========================", 0);
      KCAN.mailboxStatus();
      serial_log("", 0);
      serial_log("========================= PT-CAN =========================", 0);
      PTCAN.mailboxStatus();
      serial_log("", 0);
      serial_log("========================== DCAN ==========================", 0);
      DCAN.mailboxStatus();
      serial_log("", 0);
      uint8_t clocksrc[4] = {60, 24, 80, 0};
      sprintf(serial_debug_string, "  Serial: FlexCAN clock speed is %d MHz.", clocksrc[(CCM_CSCMR2 & 0x300) >> 8]);
      serial_log(serial_debug_string, 0);
    }
    else if (cmd == "clear_dme_dtcs") {
      if (ignition) {
        if (diag_transmit) {
          serial_log("  Serial: Clearing DME error and shadow memories - please wait.", 0);
          unsigned long time_now = millis();
          uint8_t clear_fs[] = {0x12, 3, 0x14, 0xFF, 0xFF, 0, 0, 0};
          m = {make_msg_buf(0x6F1, 8, clear_fs), time_now};
          serial_diag_dcan_txq.push(&m);
          time_now += 50;
          uint8_t clear_is[] = {0x12, 3, 0x31, 6, 0, 0, 0, 0};
          m = {make_msg_buf(0x6F1, 8, clear_is), time_now};
          serial_diag_dcan_txq.push(&m);
          time_now += 50;
          m = {clear_hs_kwp_dme_buf, time_now};
          serial_diag_dcan_txq.push(&m);
          clearing_dtcs = true;
        } else {
          obd_timeout_warning();
        }
      } else {
        serial_log("  Serial: Activate ignition first.", 0);
      }
    }
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
