superwofy/E9X-M-CAN-Integration-Module/(commit log)

2022-05-05 Upgrade KCAN to 16MHz, fix throttle, formatting.
    [E9X-M-CAN-Integration-Module.ino]
2022-05-06 Added seat heating, moved shiftlights to KCAN, added hardware photos.
2022-05-15 Re-organized CAN messages. Reworked DSC status tracking.
    [E9X-M-CAN-Integration-Module.ino]
2022-05-24 Added front foglight tracking. Improved power, tweaked ignition tracking.
2022-05-24 Streamlined CAN library. Fixed compiler warnings. Added hold for DSC OFF.
    [E9X-M-CAN-Integration-Module.ino, mcp_can.cpp]
2022-05-25 Improved DSC OFF. Added flat tyre indicator.
2022-06-06 Minor improvements. Fix USB power off seq
    [E9X-M-CAN-Integration-Module.ino, mcp_can.cpp]
2022-07-16 Improved M button timing accuracy
2022-07-16 Removed CKM. Revert ZBE wake timing.
    [E9X-M-CAN-Integration-Module.ino]
2022-07-30 Updated RPM, dsc off. Added traces and videos
2022-07-30 Revert latest can library changes
    [mcp_can.cpp]
2022-08-16 Rework ignition and DSC tracking again to fix false positives.
    [E9X-M-CAN-Integration-Module.ino]
2022-08-25 Renamed things, added cycle times, throttled 0xAA
2022-08-29 Open exhaust flap in POWER mode too.
2022-08-31 POWER-> full MDrive transition. Debug improved.
2022-08-31 Replaced 0x315 with 0x326.
    [E9X-M-CAN-Integration-Module.ino]
2022-09-01 Revert "Replaced 0x315 with 0x326."
    This reverts commit 6d5ea85d7199d0e2ea8943d7b3a145c000d191d9.
    [E9X-M-CAN-Integration-Module.ino]
2022-09-01 Decoupled POWER console button from MDrive using 0x7F1.
2022-09-03 iDrive settings control now implemented. Servotronic WIP.
2022-09-04 Servotronic now fully independent. SVT module data added.
2022-09-04 Improved SVT failure CC notification.
    [E9X-M-CAN-Integration-Module.ino]
2022-09-05 Added support for DSC OFF mode with M button.
2022-09-06 Improve MFL button, fix flap mode, improve POWER button.
    [E9X-M-CAN-Integration-Module.ino, mdrive-functions.ino, other-functions.ino, program-notes.ino]
2022-09-12 Made console POWER persistent, exhaust flap open with LC.
2022-10-25 Fix LC RPM bounce.
    [E9X-M-CAN-Integration-Module.ino]
2023-03-11 First Teensy 4.0 code
    Re-written for T4 hardware.
    [Features]
    Added DCAN forwarding for SVT70 (WIP).
    Scaling CPU frequency with demand.
    Added another Serial printout with current state for easier debugging.
    Improved engine on tracking to detect stalls etc.
    Added EEPROM initialization code for new boards.
    [E9X-M-CAN-Integration-Module.ino, board-functions.ino, canbus-test.ino, dsc-functions.ino, mcp_can.cpp, mdrive-functions.ino, other-functions.ino, shiftlight-functions.ino]
2023-03-11 Added Queuing for delayed messages
    Queue implemented for all blocking message sequences.
    Reworked all filters and messages so that they're on the closest bus.
    Queue library is included and modified due to conflict with global variable "FIFO".
    [E9X-M-CAN-Integration-Module.ino, board-functions.ino, dsc-functions.ino, mdrive-functions.ino, other-functions.ino, shiftlight-functions.ino]
2023-03-11 Added passenger seat auto heating
2023-03-12 Completed DCAN work. SVT70 now diagnosable with BMW tools.
    Forwarding between DCAN and PTCAN for the SVT now working.
    Added feature for single beep when engaging reverse.
    [E9X-M-CAN-Integration-Module.ino, board-functions.ino, canbus-test.ino, mdrive-functions.ino, other-functions.ino]
2023-03-12 Modified SVT diagnosis.
    It must now be toggled with holding POWER when ignition is turned on.
    For some reason, transmitting anything on DCAN causes other jobs to fail. UIF reads, ISTA full read, etc.
    [E9X-M-CAN-Integration-Module.ino, board-functions.ino, dsc-functions.ino, other-functions.ino]
2023-03-17 Minor improvements to timing
    Since everything is queued, we can follow the original timing as traced.
    Cache can messages instead of calculating in loop().
    Improved logic for exhaust flap.
    Hardware fixes.
    [E9X-M-CAN-Integration-Module.ino, board-functions.ino, canbus-test.ino, dsc-functions.ino, exhaust-test.ino, led-test.ino, mdrive-functions.ino, other-functions.ino]
2023-03-18 Re-organized loop. Moved some code around. Improved flap,dsc,engine on.
    Modified the way exhaust flap opens.
    Moved the console buttons evaluation out of the main file.
    Simplified control flow in a few areas.
    Added watchdog timer.
    Underclocked/undervolted.
    Fix engine ON tracking.
    Fix regression in saving MDrive settings.
    [E9X-M-CAN-Integration-Module.ino, Watchdog_t4.h, board-functions.ino, dsc-functions.ino, mdrive-functions.ino, other-functions.ino]
2023-03-19 Rework watchdog, cpu temp, ignition tracking, fog tracking.
    [E9X-M-CAN-Integration-Module.ino, board-functions.ino, dsc-functions.ino, mdrive-functions.ino, other-functions.ino]
2023-03-19 Add RTC code. HW - WIP.
    When the car's time is lost, the program will fix it.
    Small fix for ignition tracking in CA cars.
    [E9X-M-CAN-Integration-Module.ino, board-functions.ino, body-functions.ino, other-functions.ino]
2023-03-19 Fix faulty engine on tracking.
    [E9X-M-CAN-Integration-Module.ino, board-functions.ino, body-functions.ino, shiftlight-functions.ino]
2023-03-20 Remove now unnecessary LC coupling to exhaust flap.
2023-03-20 Fix silly mistake causing animation to stick on.
    Fixed ambient temp display.
    Better time formatting.
    [board-functions.ino, body-functions.ino, other-functions.ino, shiftlight-functions.ino]
2023-03-23 Add RTC update from DCAN.
    Also rate limited M button press - only for DTC/MDM.
2023-03-26 Fix for LDM refusing to flash. Add M Key POWER setting.
    Deactivate PTCAN transceiver when diagnostic queries are sent to the LDM.
    - Flashing through WinKFP fails otherwise. Only for this module.
    Control POWER mode persistently through iDrive.
    Flash shiftlights when LC is active.
    [E9X-M-CAN-Integration-Module.ino, board-functions.ino, body-functions.ino, dsc-functions.ino, mdrive-functions.ino, other-functions.ino, shiftlight-functions.ino]
2023-04-02 Tidy up. Fix an Audio edge case.
    [E9X-M-CAN-Integration-Module.ino, board-functions.ino, body-functions.ino, mdrive-functions.ino]
2023-04-02 Renamed variables more consistently..
    Made sure directives compile correctly.
    [E9X-M-CAN-Integration-Module.ino, board-functions.ino, body-functions.ino, dsc-functions.ino, mdrive-functions.ino, other-functions.ino]
2023-04-03 Tweak audio further. Moved heating code.
    More guards, checks and changed to closer buses.
    Improved passenger seat heating function
2023-04-13 Correct iDrive tx deactivation during diagnosis.
    [E9X-M-CAN-Integration-Module.ino, board-functions.ino, body-functions.ino]
2023-04-24 Add pseudo-HDC, MSA, Needle Sweep, DRL dimming.
    This commit is massive. Sorry future me.
    The MSA+HDC code will allow the two blank buttons (Hill Descent Control and Auto Start Stop) to serve some (limited) functions. Better than being blank :).
    Added CC Gong for max RPM upshift.
    Add needle sweep animation.
    Added validation check for RTC.
    Separated seat heating queues.
    Added CAN message transmission error tracking.
    Added a fix for EDC ckm not matching.
    Re-worked ignition tracking.
    Unified disable of 6F1 transmission when OBD tool is connected.
    [E9X-M-CAN-Integration-Module.ino, board-functions.ino, body-functions.ino, dsc-functions.ino, mdrive-functions.ino, other-functions.ino, shiftlight-functions.ino]
2023-04-25 Tweak MSA and HDC
    HDC is still WIP.
    Fixed some logic errors.
    Improved dimming behavior.
    Fix ignition tracking when comfort access key not detected.
    Added a file with the coding parameters I use.
    Tweak needle sweep delays.
    Make sure LC is not displayed in reverse.
    [coding parameters.txt]
2023-04-29 Decoupled passenger seat heating from driver.
2023-05-11 New features
    Add front fog cornering light.
    Add mirror fold/unfold when locking.
    Add key profile number support.
    Updated EDC CKM fix.
    Added a serial control interface.
    Modified DRL off with ignition behavior.
    Modified EEPROM saving behavior.
    Fix DCAN transceiver issue.
    [E9X-M-CAN-Integration-Module.ino, board.ino, body.ino, canbus-test.ino, chassis.ino, driver-information.ino, mdrive.ino, network-management.ino]
2023-05-13 Added extra MHD exceptions for diag.
    Tweaked EDC fix again.
    [E9X-M-CAN-Integration-Module.ino, mdrive.ino, program-functions.ino]
2023-05-14 Slight tweak for 0x315 and its fakes to fix LDM.
    LDM fix no longer required.
    Changed DME fake 0x315 ID and transmit frequency.
    The high ID (0x7F1) caused LDM programming issues.
    Transmitting together with 0x130 increases bus load for no reason.
    [E9X-M-CAN-Integration-Module.ino, board.ino, body.ino, driver-information.ino, mdrive.ino, network-management.ino, program-functions.ino]
2023-05-17 Corrections/fixes.
    Some renames.
    Moved battery voltage filter to PT-CAN.
    Tweaked compiler directives.
    Created an alive monitor for the iDrive.
    Modified fold/un-fold behavior.
    Improved fog corner.
    [E9X-M-CAN-Integration-Module.ino, board.ino, body.ino, chassis.ino, driver-information.ino, mdrive.ino, network-management.ino, program-functions.ino]
2023-05-18 Reduced start-up time
    Changed HDC speeds again.
    Fixed a regression where send power mode is not limited.
    Fixed SVT diagnosing issue.
    Update docs.
    [E9X-M-CAN-Integration-Module.ino, body.ino, chassis.ino, driver-information.ino, network-management.ino, serial.ino]
2023-05-20 Built an anti-theft function.
    Tweak iDrive timeout.
    Tweak FRM coding interfering with mirror fold.
    Tweak corner fogs. Not very reliable for now...
    Tweak Needle sweep animation.
    Tweak mirror folding.
    Tweak CPU scaling.
    [coding parameters.txt]
2023-05-20 Rebuilt fog corner feature.
    Now based on steering angle. It works in addition to AHL cornering and separately. Tying it to the AHL corners makes it come on very often.
    Soft-on/off effect added.
    Some reliability improvements.
2023-05-20 Broke up source files. No code changes.
    [E9X-M-CAN-Integration-Module.h, E9X-M-CAN-Integration-Module.ino, body-exterior.ino, body-interior.ino, drivetrain.ino]
2023-05-21 Improved fold, anti-theft and serial control.
    Alarm will sound if engine is started without releasing anti-theft.
    Un-fold can now be triggered by a door open instead.
    Status can be printed to main Serial now.
2023-05-21 More fixes.
    Added acknowledge when releasing anti theft with terminal R off.
    Added a delay for the acknowledge sent with terminal R on.
    Tweak alarm disable when stall tripped.
    Tweak fog corner deactivation conditions.
    Fix iDrive volume regression.
    [E9X-M-CAN-Integration-Module.h, E9X-M-CAN-Integration-Module.ino, body-exterior.ino, body-interior.ino, chassis.ino, drivetrain.ino, serial.ino]
2023-05-22 Re-worked clocks according to spec.
    Previous thresholds were way too low.
    Tweak ambient temperature monitoring.
    [E9X-M-CAN-Integration-Module.h, E9X-M-CAN-Integration-Module.ino, board.ino, body-exterior.ino, body-interior.ino, program-functions.ino, serial.ino]
2023-05-24 Tweaks and fixes.
    Increased gong with RPM threshold.
    Changed the steering angle required when fog cornering with indicators on.
    Correct EKP jobs being sent on KCAN instead of PTCAN. Made EKP disable run with engine on to ensure priming runs successfully.
    Increased the size of queues to one of two standard sizes. 16 or 32. Ensured all queues are flushed.
    Increased stall alarm duration.
    Changed anti-theft startup conditions to allow more priming.
    Simplified timers.
    Improved serial jobs.
    [E9X-M-CAN-Integration-Module.h, E9X-M-CAN-Integration-Module.ino, board.ino, body-exterior.ino, body-interior.ino, chassis.ino, driver-information.ino, drivetrain.ino]
2023-05-27 Improved timing.
    Reduced startup time to 2ms or less.
    Fixed an issue with RTC validation.
    Fix fog mistake.
    Added speed limitation to fog corner to better imitate original behavior.
    Made sure startup delay bypass is made before timers are initialized.
    Improved DSC OFF button behavior.
    Made anti-theft release safer for software resets.
    Updated function declarators.
    Made CAN filter setting much simpler.
    [E9X-M-CAN-Integration-Module.h, E9X-M-CAN-Integration-Module.ino, board.ino, body-exterior.ino, body-interior.ino, chassis.ino, driver-information.ino, drivetrain.ino]
2023-06-04 Add RVC button in place of MSA button. HW WIP.
    Improve stability of door open volume reduction by disabling CAS CC. Removed volume_requested check as it is superfluous. Made the volume restore slightly softer.
    Consolidated anti-theft code. Improved the way the DWA LED is displayed. Increased siren duration to 5 min.
    Added basic password protection to Serial interface.
    Rework reverse beep/gong.
    Disable DCAN transceiver when diagnosis is detected.
    Added USB disable code.
    [coding parameters.txt]
2023-06-05 Corrections / updates. Added extra wipe after washing windhsield.
    Corrected transceiver activation.
    Increase max filters.
    Changed door status message.
    Changed POWER CKM sync message.
    Added diagnosis exception for EKP disable.
    DWA led activation conditions improved.
    Added a CC gong when hood is unlatched.
    Matched volume reduce/restore.
    Added FRM AHL mode switcing with MDrive.
    [E9X-M-CAN-Integration-Module.h, E9X-M-CAN-Integration-Module.ino, board.ino, body-exterior.ino, body-interior.ino, chassis.ino, drivetrain.ino, network-management.ino]
2023-06-10 Fix alarm.
    Minor change to passenger auto seat heating.
    [E9X-M-CAN-Integration-Module.h, board.ino, body-interior.ino, drivetrain.ino]
2023-07-28 New features
    Auto steering heating
    Functionality to control F01 video switch module and NIVI night vision modules from tool32.
    Added real checksumming to protect EEPROM values.
    Improved the serial module.
    Can now persistently disable the anti-theft function.
    Various fixes.
    [2FB VSW config.txt]
2023-07-30 More F-series messages
    163 - Done
    1A1 - Done
    199 - WIP
    19F - WIP
    2A5 - WIP
    3A0 - Done
    3F9 - Done
    Packaged CRC library.
    [2FB VSW config.txt]
2023-08-03 Updates
    Modified Fog corner conditions. Available in reverse now.
    Add visual indicator for trunk open with remote.
    Now saving the idrive volume in eeprom and restoring at boot instead of "default" value.
    Fixes to various components.
    [E9X-M-CAN-Integration-Module.h, E9X-M-CAN-Integration-Module.ino, board.ino, body-exterior.ino, body-interior.ino, chassis.ino, drivetrain.ino, network-management.ino]
2023-08-08 Tweaks
    Changed indicator flash condition.
    Fixed SVT diagnosis so that it can be always on.
    Trunk indicator respects CKM setting.
    Fix tilt, implemented longitudinal acceleration.
    Improved error handling.
    [E9X-M-CAN-Integration-Module.h, E9X-M-CAN-Integration-Module.ino, board.ino, body-exterior.ino, body-interior.ino, canbus-test.ino, chassis.ino, driver-information.ino]
2023-08-28 Various fixes.
    Improved serial.
    Fixes for RTC.
    Alarm led activation should be more consistent.
    Add detection for low power modes and 30G reset.
    Fix bus error detection.
    Changed HDC ranges to resemble factory.
    Improved HDC button detection.
    Changed volume reduce conditions.
    [E9X-M-CAN-Integration-Module.h, E9X-M-CAN-Integration-Module.ino, board.ino, body-exterior.ino, body-interior.ino, chassis.ino, drivetrain.ino, network-management.ino]
2023-08-29 Simplified compiler directives
    It should be slightly easier to follow the program flow with fewer mistakes when initializing and updating variables.
    [E9X-M-CAN-Integration-Module.h, E9X-M-CAN-Integration-Module.ino, board.ino, body-exterior.ino, body-interior.ino, chassis.ino, driver-information.ino, drivetrain.ino]
2023-09-02 ASD control, fixes
    ASD amplifier muted/demuted with MDrive POWER Sport+.
    Better detection for AHL
    Better detection for hood and trunk open.
    Added a timer to the Reverse beep reminder.
    Added CAN switch for NiVi. Restricted messages to ignition ON.
    Small Serial improvements.
    Fix volume request conflict with periodic.
    Fix longitudinal acceleration.
    Add auto PDC OFF when out of reverse and pulling handbrake.
    [E9X-M-CAN-Integration-Module.h, E9X-M-CAN-Integration-Module.ino, board.ino, body-exterior.ino, body-interior.ino, chassis.ino, driver-information.ino, drivetrain.ino]
2023-09-07 Mirror undim when turning at night
    Mirror undim when turning at night with indicators on.
    Tweak ASD control.
    Tied AHL mode to Servotronic mode.
    Move dr seat back when exiting.
    Restrict door volume with terminal R only.
    Add Yaw rate.
    Add CKM tracking to DIM_DRL.
    [coding parameters.txt]
2023-09-10 Fixes
    Fix reverse beep still coming on despite conditions not being met.
    Simplified some message transmissions.
    Fix EKP diagnosis exception.
    [E9X-M-CAN-Integration-Module.h, driver-information.ino, drivetrain.ino, network-management.ino]
2023-09-13 Fix auto pdc off
    Restricted corner fogs from running during daytime.
    Reduced frequency of corner fogs on/off.
    Added flash to shiftlights startup animation.
    Added auto RVC dip when reversing.
    [coding parameters.txt]
2023-09-16 RVC dip and serial improvements.
    Changed RVC dip thresholds and activation.
    Changed door volume when PDC active.
    Add serial unlock timeout and persistence.
    Added serial command to enter full sleep mode.
    Changed reverse beep.
    Fix corrupted EEPROM init.
    [E9X-M-CAN-Integration-Module.h, E9X-M-CAN-Integration-Module.ino, board.ino, body-interior.ino, chassis.ino, driver-information.ino, drivetrain.ino, network-management.ino]
2023-09-22 Tweaks
    Allow bypass for quiet start with MDrive ON.
    Ensured flap opens/closes when adjusting MDrive settings.
    Allow trunk flash while engine running.
    Mirror undim will not happen unless indicator stalk fully depressed now.
    Added a way to force sleep mode with the remote lock button.
    Added door lock tracking to improve remote functions.
    Serial interface locks with car.
    Added flashing hazards when lock button pressed and car is locked.
    Small changes to startup. CAN init takes 2ms, full setup 27ms.
    HDC fixes.
    [E9X-M-CAN-Integration-Module.h, E9X-M-CAN-Integration-Module.ino, board.ino, body-exterior.ino, body-interior.ino, chassis.ino, driver-information.ino, drivetrain.ino]
2023-10-09 Improvements
    Key/iDrive profile handling now working.
    Improved EEPROM saving consistency.
    Simplified mirror fold.
    Added startup volume restriction at night.
    Added a debounce to the tow view with PDC distance.
    Fix comfort exit not working with both doors open.
    Added missing door states.
    Add intermittent wiping.
    [E9X-M-CAN-Integration-Module.h, E9X-M-CAN-Integration-Module.ino, board.ino, body-exterior.ino, body-interior.ino, chassis.ino, driver-information.ino, drivetrain.ino]
2023-10-17 Fix startup
    Changed activation condition for intermittent wipers.
    Changed CAN init. Included modified library with faster filter set.
    Reduced Teensy core modifications and total startup time to 1.6ms (cold).
    Reduced startup power consumption.
    Reduced half-wake power consumption.
    Added ability to extract early serial messages from boot.
    Changed auto steering heater conditions.
    Fixed hazards flash not coming on first time when waking.
    Improved alarm activation/deactivation consistency.
    Fixed auto heated seat on pass side.
    Added stages to auto seat heating.
    Fix RVC settings issue.
    [E9X-M-CAN-Integration-Module.h, E9X-M-CAN-Integration-Module.ino, FlexCAN_T4.h, board.ino, body-exterior.ino, body-interior.ino, chassis.ino, circular_buffer.h]
2023-10-22 Fix for RVC and standby.
    Tweak wiping times. Documented factory times.
    Fix sporadic wake issue.
    Add RTC time/date to boot log.
    Fixes for RVC tow activation.
    [E9X-M-CAN-Integration-Module.h, E9X-M-CAN-Integration-Module.ino, body-interior.ino, drivetrain.ino, network-management.ino, program-functions.ino, serial.ino]
2023-10-25 Add MCP2515 lib and re-org repo
    [2FB VSW config.txt]
2024-01-23 Add pre NBT changes
    Re-structured CAN message definitions.
    Added new messages used by NBT.
    Added traces from an F series car.
    Added NBT screenshots.
    [0x2FB VSW config.txt, 2FB VSW config.txt, F11 KCAN.csv, coding parameters.txt]
2024-01-23 Added NBT ID3 support
    Implemented fourth bus component through MCP2515 to emulate BN2010 KCAN2.
    Added DTC clearing for NBT, ZBE and TBX.
    Improved F chassis messages.
    Tweak seat heating thresholds.
    Added speed factor to intermittent wiping thresholds.
    Add more debouncing and speed limiting to tow view.
    Adapted VSW for NBT use.
    Translated buttons and rotation for CCC controllers.
2024-02-03 v1.0.121
    Adopted a simple versioning system that counts commits.
    -Added Sport+ placeholder for SVT.
    -Added real engine temperatures to 0x3F9.
    -Fix for AUTO blower speed not being adjustable without CIC.
    -Added functionality to display custom messages in CC notifications.
    -Display auto blower speed in custom CC.
    [E9X-M-CAN-Integration-Module.h, E9X-M-CAN-Integration-Module.ino, board.ino, body-interior-hu.ino, body-interior.ino, chassis.ino, driver-information.ino, drivetrain.ino]
2024-02-17 Update traces
    Removed 0x380 from traces to avoid CP on HU when replaying.
    Removed 0x330 to prevent odometer issues.
    [F11 KCAN.csv]
2024-02-19 Add M3 trace
2024-02-27 v1.0.124
    -Added ID5/6 support.
    -Adjusted SoC evaluation.
    -CCC ZBE now legacy.
    -Adjusted chassis messages.
    -Improved diagnostics of FXX modules.
    -Add pressure unit handling.
    -Add startup animation for sport displays.
    -Add angles for X_VIEW.
    [coding parameters.txt]
2024-03-04 v1.0.125
    -Tweaked 0x399 frequency closer to original values.
    -Added Xantorhd's LC display serial commands.
    -Slowed xDrive status angle display.
    -Fix for automatic time set to 00:00 1/1/2000 on boot.
    -Increased daytime screen brightness.
    -Adapted for gateway table 7.
    -Oil measuring now working like CIC.
    [coding parameters.txt]
2024-05-20 v1.0.126
    -Removed "new" style oil measurement.
    -Updated handling of units and format settings.
    -Improved DTC clearing.
    -Added RAD_ON control through ASD module.
    -Fix engine off race condition.
    -Fix inconsistent camera activation.
    -Fix gyro calculation, GW7 CANID.
    -Fix RLS time of day not available with ignition OFF.
    -Improved F steering angle handling.
    -Added menu control to EVO like in CIC.
    -Added more checking to mirror unfold.
    -Added filtering for some empty CCs.
    [coding parameters.txt]
2024-05-26 v1.0.127
    -Add custom CCs for EVO. Enhanced existing features with new dialogs.
    -Show water temp, IAT, voltage and boost pressure in CC list.
    -Implemented more CCs native to EVO that aren't available in BN2000.
    -Added a way to enable/disable high beam assistant using the indicator stalk.
    -Fixed home lights setting.
    -Implemented Sport+ setting by setting SVT70 PWM to zero.
    [E9X-M-CAN-Integration-Module.h, E9X-M-CAN-Integration-Module.ino, board.ino, body-exterior.ino, body-interior-hu.ino, body-interior.ino, chassis.ino, driver-information.ino]
2024-06-17 Update documentation and libs
    [F11 KCAN.csv, Terminal 30G OFF to Terminal R power management KCAN.csv, Terminal R to full 30G cutoff with iDrive ON KCAN.csv]
2024-06-17 v1.0.129
    -Minor boost bar changes.
    -Reworked power/network management. Listening to the HU with terminal R off now possible like with CIC/CCC.
    -Fix battery voltage formula.
    -Fix indicated speed formula.
    -Fix steering angle formula.
    -Fix passenger seat status tracking.
    -Added F throttle pedal position and torque.
    -Cleanup, refactoring and deprecation.
    [coding parameters.txt]
2024-06-28 v1.0.131
    -Fix some custom CCs.
    -Fix home lights setting on slow iDrive boots.
    -Improve alarm LED control.
    -Improved wipe after windscreen wash conditions.
    -Improved sleep power consumption by waking transceivers only when needed.
    -Add comfort close complete indicator.
    [E9X-M-CAN-Integration-Module.h, E9X-M-CAN-Integration-Module.ino, board.ino, body-exterior.ino, body-interior-hu.ino, body-interior.ino, chassis.ino, driver-information.ino]
2024-07-17 v1.0.132
    -Added interior temperature to auto seat/steering heating evaluation.
    -Improved comfort exit conditions.
    -Power management bug fixes.
    -Simplified auto volume reduction.
    -Correct wipe after wash regression.
    -Enhanced hazard flashing for car finder.
    -Further deprecation. HUs supported are now CIC and EVO ID5/6.
    [E9X-M-CAN-Integration-Module.h, E9X-M-CAN-Integration-Module.ino, board.ino, body-exterior.ino, body-interior-hu.ino, body-interior.ino, chassis.ino, driver-information.ino]
2024-10-06 v1.0.133
    -Tweaked CID brightness bias.
    -Simpler and more reliable CC processing.
    -Add auto re-scale for max boost.
    -Improved SVT70 PWM control.
    -Added inhibition of DSC OFF if an object rests on the button.
    -Re-implemented proper DSC mode tracking.
    -Update lib.
    [0x2FB VSW config.txt]
2024-10-17 v1.0.134
    -Faceplate UART improvements.
    -Simplified error clearing.
    -Increased brightness.
    -Restricted DSC mode changes during dangerous situations.
    -Begin PTC heater integration.
    [E9X-M-CAN-Integration-Module.h, E9X-M-CAN-Integration-Module.ino, body-interior-hu.ino, body-interior.ino, chassis.ino, drivetrain.ino, network-management.ino, program-functions.ino]
2024-10-23 v1.0.135
    -New O(1) CANID processing and forward filtering.
    -Corrected Up/Down MFL buttons for EVO.
    -Modified engine run signal.
    -Added alarm beep to car finder.
    [E9X-M-CAN-Integration-Module.h, E9X-M-CAN-Integration-Module.ino, board.ino, body-exterior.ino, body-interior-hu.ino, body-interior.ino, chassis.ino, driver-information.ino]
